mi83ki/servo-pcb/README.md

# servo-pcb

XSA2の本丸駆動用サーボ基板

## 構想設計図

構想設計図は以下になります。
モバイルバッテリー、基板、XSA2を全て回転台の上部に搭載することで、360度回転を継続できる構造とします。
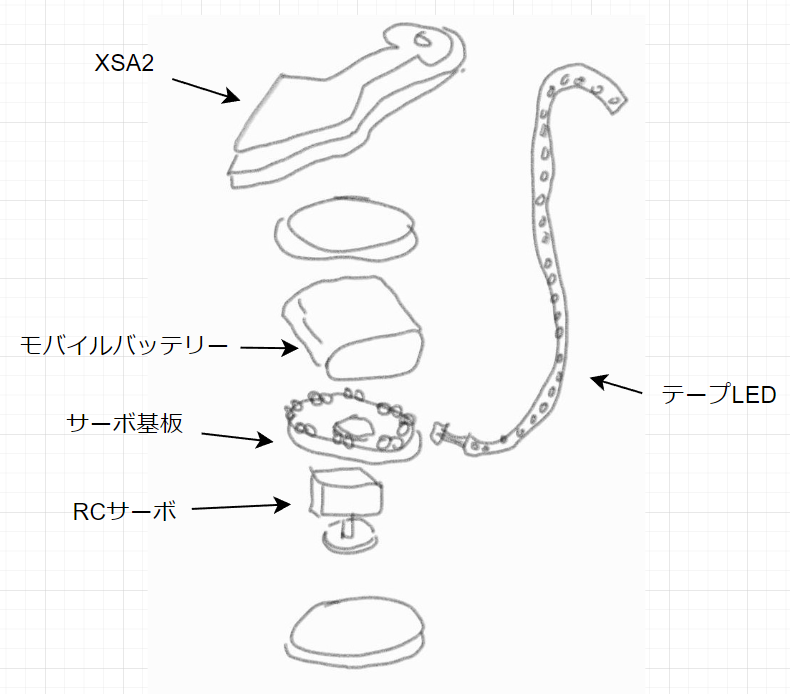
[picture p1: images/conceptualDesign.png]
構想設計図


## 回路ブロック図

回路ブロック図は以下になります。
赤外受発光基板をシールド基板にすることで、拡張可能とします。
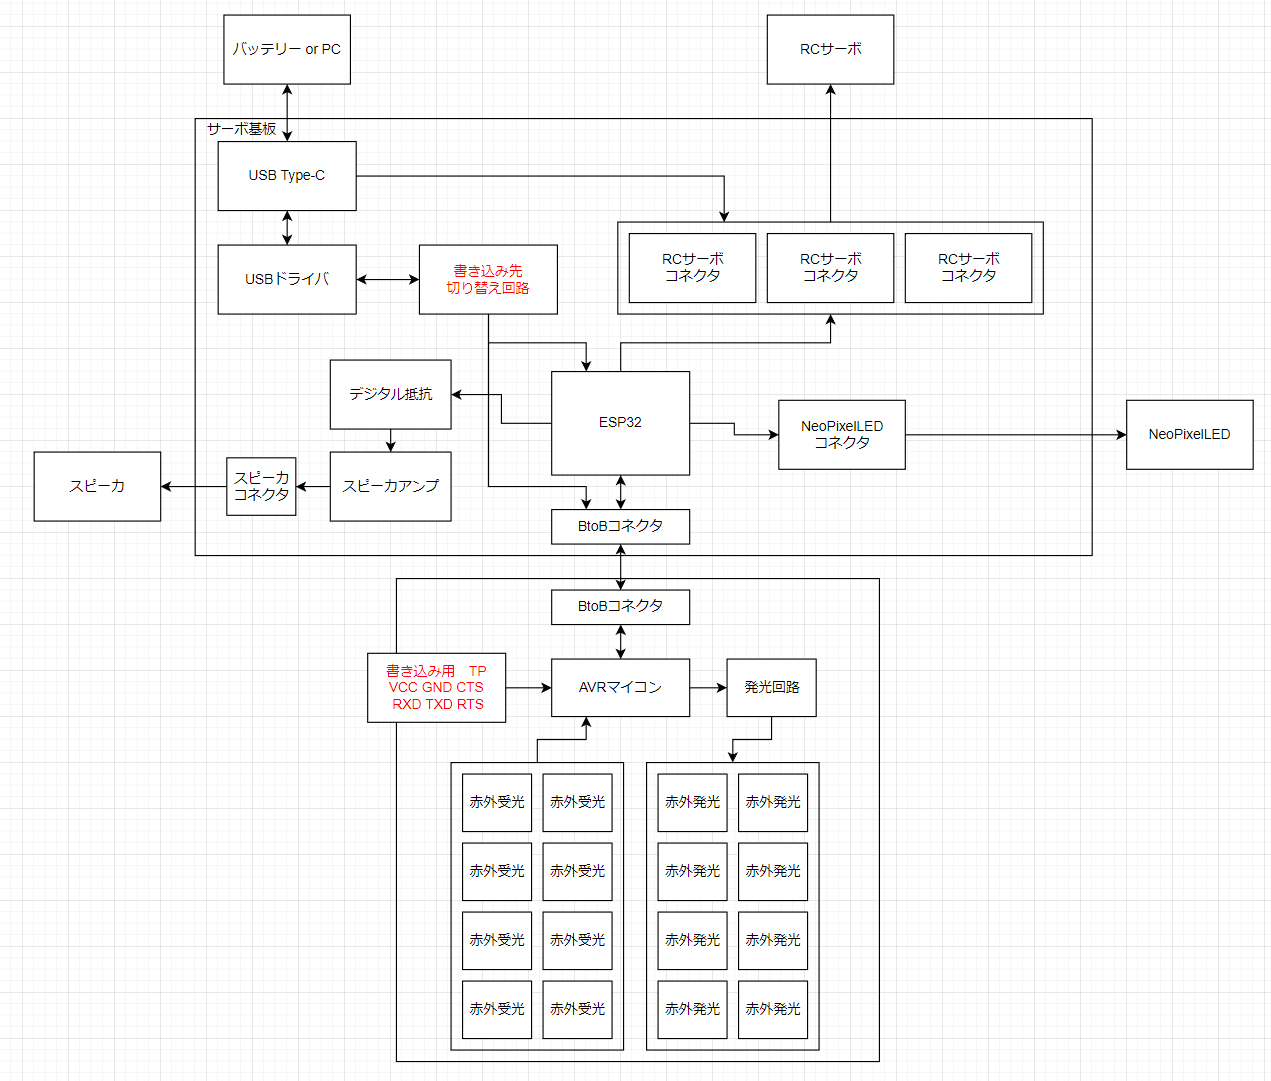
[picture p2: images/circuitDiagram.png]
回路ブロック図
