mi83ki/servo-pcb/dxf/ASSY_ir-pcb_draw.dxf

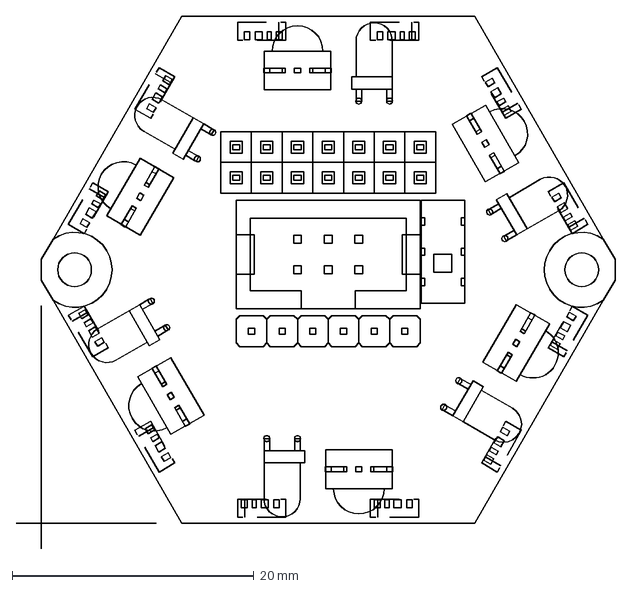
[picture p3: CAD file, 2022-11-27]
dxf/ASSY_ir-pcb_draw.dxf
49.6 x 44.1 mm
