mi83ki/servo-pcb/dxf/ASSY_servo-pcb_draw.dxf

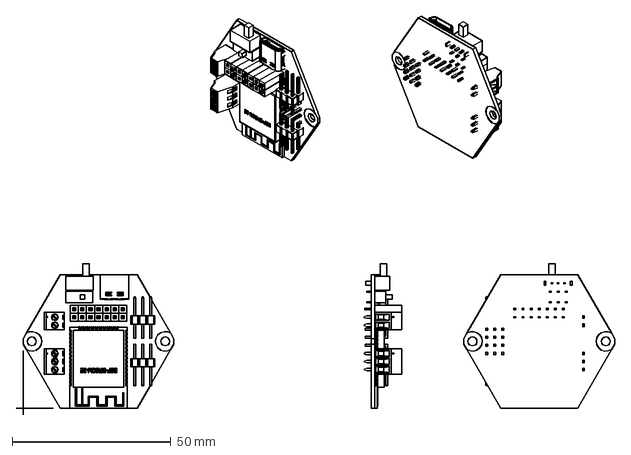
[picture p4: CAD file, 2022-09-03]
dxf/ASSY_servo-pcb_draw.dxf
188.3 x 125.4 mm
