mi83ki/servo-pcb/dxf/pcb_sheet_draw.dxf

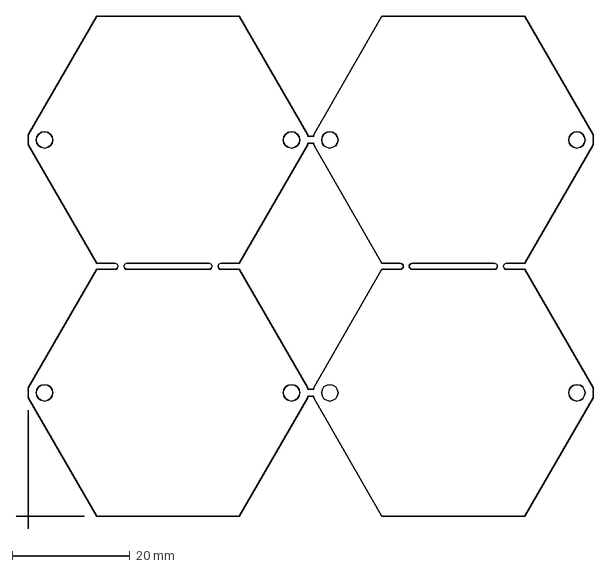
[picture p5: CAD file, 2022-09-03]
dxf/pcb_sheet_draw.dxf
98.1 x 87.1 mm
