mi83ki/servo-pcb/ltspice/IR_led_PMOS.asc

R1: res; 1k
R2: res; 2.5
R3: res; 1k
U1: 2SJ168
V1: voltage; 5
V2: voltage; PULSE(0 3.3 0 0 0 0.01m 0.0263m); AC 1
Named nets: 0
;tran 0.1m
.ac oct 5m 10 100k
