mi83ki/servo-pcb/eagle/xsa2-servo-pcb/servo-pcb.brd

## EAGLE design eagle/xsa2-servo-pcb/servo-pcb.brd (2022-11-27)

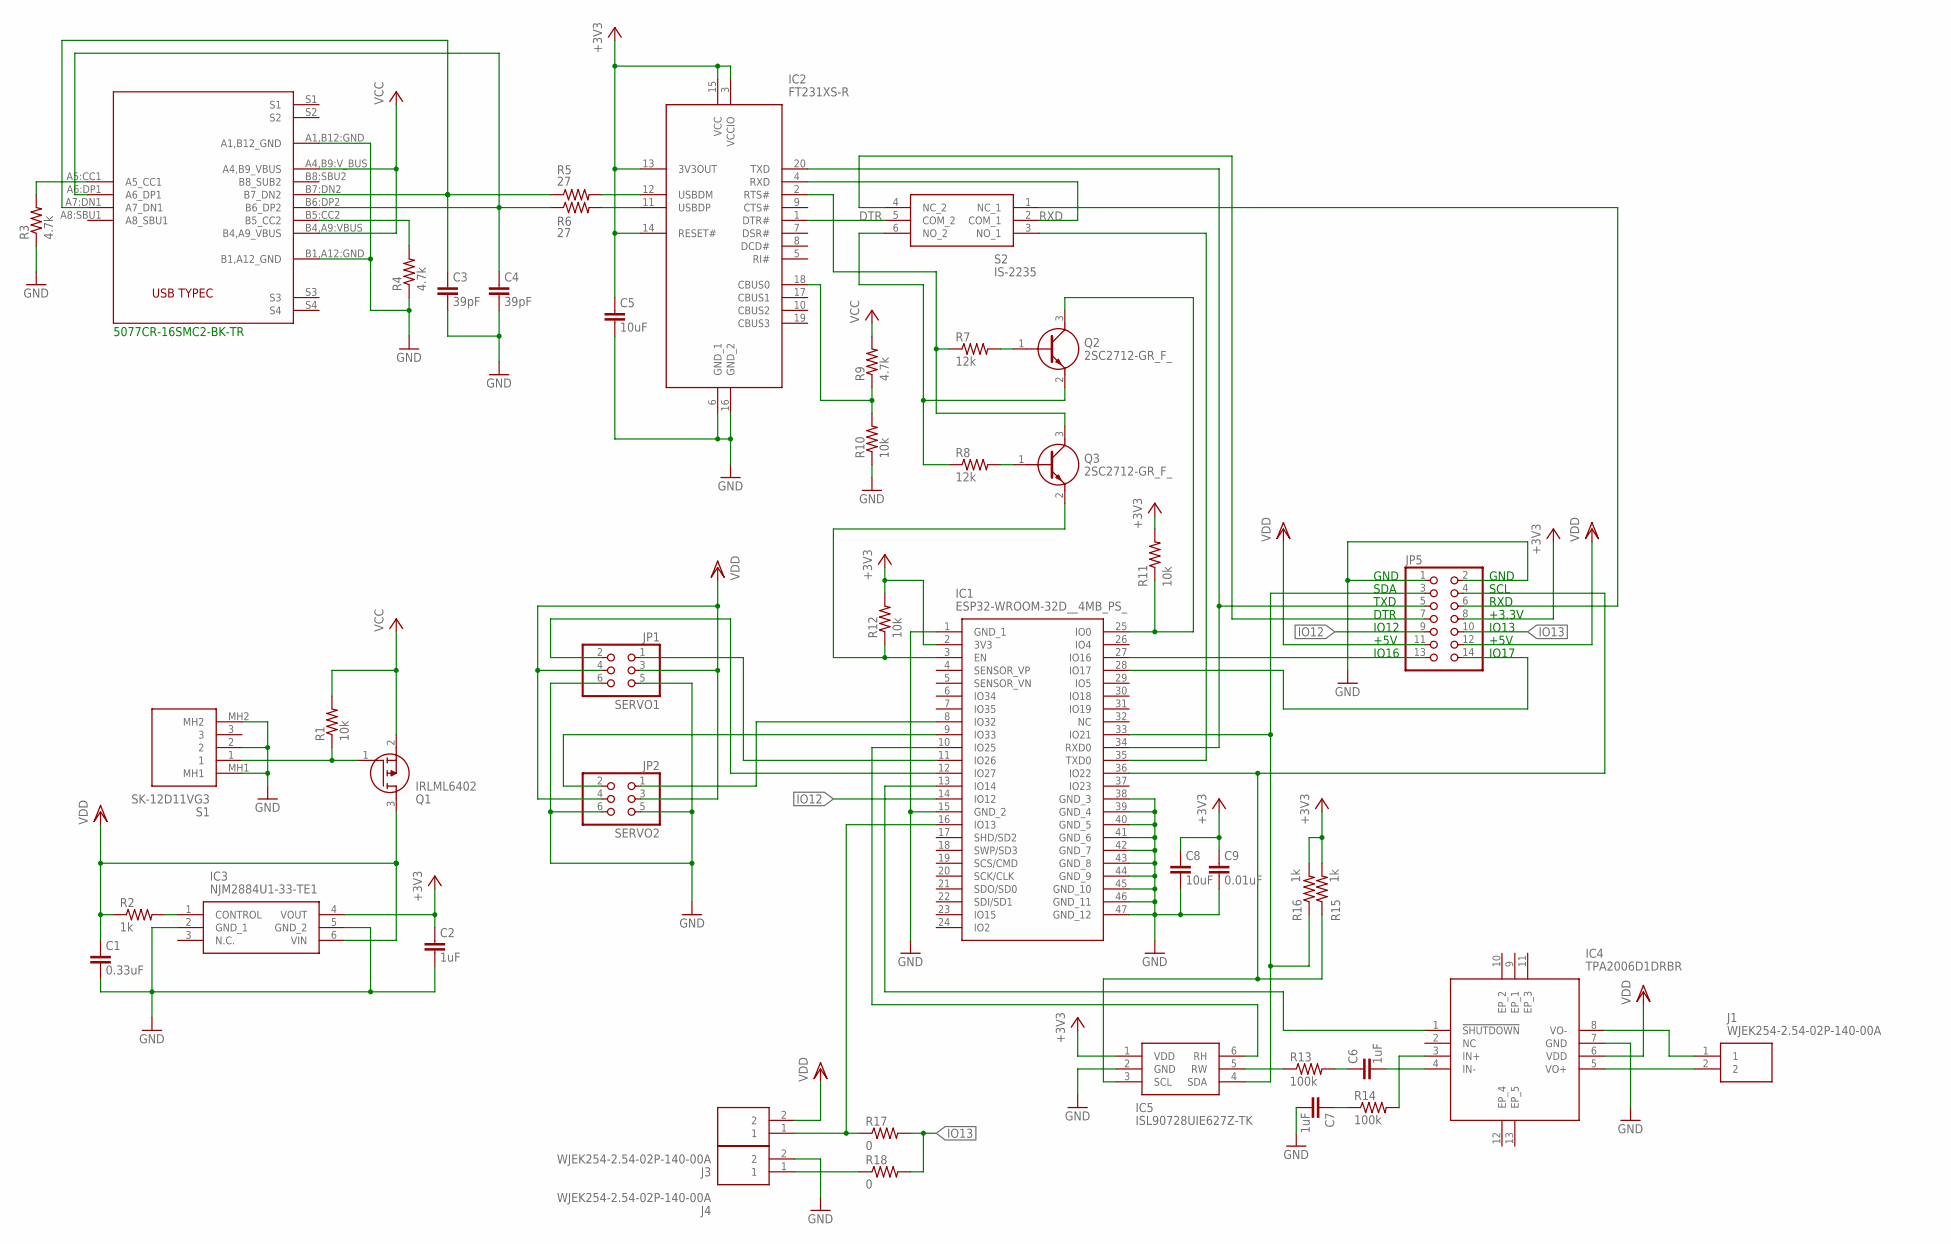
[picture p6: schematic servo-pcb.sch]

Parts:
C1: 0.33uF; C0603
C2, C6, C7: 1uF; C0603
C3, C4: 39pF; C0603
C5, C8: 10uF; C0805
C9: 0.01uF; C0603
IC1: ESP32-WROOM-32D__4MB_PS_; ESP32WROOM32D4MBPS
IC2: FT231XS-R; SOP64P599X175-20N
IC3: NJM2884U1-33-TE1; SOT-89-5-1
IC4: TPA2006D1DRBR
IC5: ISL90728UIE627Z-TK; SOT65P210X110-6N
J1, J3, J4: WJEK254-2.54-02P-140-00A; WJEK25425402P14000A
JP1: SERVO1; 2X03/90
JP2: SERVO2; 2X03/90
JP5: PINHD-2X7; 2X07
Q1: IRLML6402; SOT95P237X112-3N
Q2, Q3: 2SC2712-GR_F_; SSM3K7002CFULF
R1, R10, R11, R12: 10k; R0603
R2, R15, R16: 1k; R0603
R3, R4, R9: 4.7k; R0603
R5, R6: 27; R0603
R7, R8: 12k; R0603
R13, R14: 100k; R0603
R17, R18: 0; R0603
S1: SK-12D11VG3; SK12D11VG3
S2: IS-2235; IS2235
U$1: 5077CR-16-SMC2-BK-TR; 5077CR-16SMC2-BK-TR

Connections:
+3V3: C2.1, C5.1, C8.1, C9.1, IC1.2 (3V3), IC2.3 (VCCIO), IC2.13 (3V3OUT), IC2.14 (RESET#), IC2.15 (VCC), IC3.4 (VOUT), IC5.1 (VDD), JP5.8, R11.2, R12.2, R15.2, R16.2
DTR: IC2.1 (DTR#), S2.5 (COM_2)
GND: C1.2, C2.2, C3.2, C4.2, C5.2, C7.2, C8.2, C9.2, IC1.1 (GND_1), IC1.15 (GND_2), IC1.38 (GND_3), IC1.39 (GND_4), IC1.40 (GND_5), IC1.41 (GND_6), IC1.42 (GND_7), IC1.43 (GND_8), IC1.44 (GND_9), IC1.45 (GND_10), IC1.46 (GND_11), IC1.47 (GND_12), IC2.6 (GND_1), IC2.16 (GND_2), IC3.2 (GND_1), IC3.5 (GND_2), IC4.7 (GND), IC5.2 (GND), J4.2, JP1.5, JP1.6, JP2.5, JP2.6, JP5.1, JP5.2, R3.1, R4.1, R10.1, S1.2, S1.MH1, S1.MH2, U$1.A1,B12:GND (A1,B12_GND), U$1.B1,A12:GND (B1,A12_GND)
IO12: IC1.14 (IO12), JP5.9
IO13: JP5.10, R17.2, R18.2
unnamed: C4.1, R6.1, U$1.A6:DP1 (A6_DP1), U$1.B6:DP2 (B6_DP2)
unnamed: Q1.1 (G), R1.1, S1.1
unnamed: IC3.1 (CONTROL), R2.2
unnamed: IC1.28 (IO17), JP5.14
unnamed: C3.1, R5.1, U$1.A7:DN1 (A7_DN1), U$1.B7:DN2 (B7_DN2)
unnamed: IC1.34 (RXD0), IC2.20 (TXD), JP5.5
unnamed: IC2.12 (USBDM), R5.2
unnamed: IC2.11 (USBDP), R6.2
unnamed: IC2.2 (RTS#), Q3.3 (C), R7.1
unnamed: Q2.1 (B), R7.2
unnamed: Q2.2 (E), R8.1, S2.6 (NO_2)
unnamed: Q3.1 (B), R8.2
unnamed: IC2.18 (CBUS0), R9.1, R10.2
unnamed: IC1.3 (EN), Q3.2 (E), R12.1
unnamed: IC1.25 (IO0), Q2.3 (C), R11.1
unnamed: IC1.35 (TXD0), S2.3 (NO_1)
unnamed: JP5.7, S2.4 (NC_2)
unnamed: IC5.5 (RW), R13.1
unnamed: C6.1, R13.2
unnamed: C6.2, IC4.4 (IN-)
unnamed: IC4.3 (IN+), R14.2
unnamed: C7.1, R14.1
unnamed: IC1.36 (IO22), IC5.3 (SCL), JP5.4, R15.1
unnamed: IC1.33 (IO21), IC5.4 (SDA), JP5.3, R16.1
unnamed: IC1.13 (IO14), IC4.1 (!SHUTDOWN)
unnamed: IC4.8 (VO-), J1.1
unnamed: IC4.5 (VO+), J1.2
unnamed: IC1.10 (IO25), IC5.6 (RH)
unnamed: IC1.16 (IO13), J3.1, R17.1
unnamed: IC1.11 (IO26), JP1.1
unnamed: IC1.12 (IO27), JP1.2
unnamed: IC1.8 (IO32), JP2.1
unnamed: IC1.9 (IO33), JP2.2
unnamed: IC1.27 (IO16), JP5.13
unnamed: R4.2, U$1.B5:CC2 (B5_CC2)
unnamed: J4.1, R18.1
unnamed: JP5.6, S2.1 (NC_1)
unnamed: R3.2, U$1.A5:CC1 (A5_CC1)
RXD: IC2.4 (RXD), S2.2 (COM_1)
VCC: Q1.2 (S), R1.2, R9.2, U$1.A4,B9:V_BUS (A4,B9_VBUS), U$1.B4,A9:VBUS (B4,A9_VBUS)
VDD: C1.1, IC3.6 (VIN), IC4.6 (VDD), J3.2, JP1.3, JP1.4, JP2.3, JP2.4, JP5.11, JP5.12, Q1.3 (D), R2.1

Notes on the sheet:
RXD
TXD
DTR
SDA
SCL
IO16
IO17
IO13
IO12
+5V
GND
5077CR-16SMC2-BK-TR
+3.3V

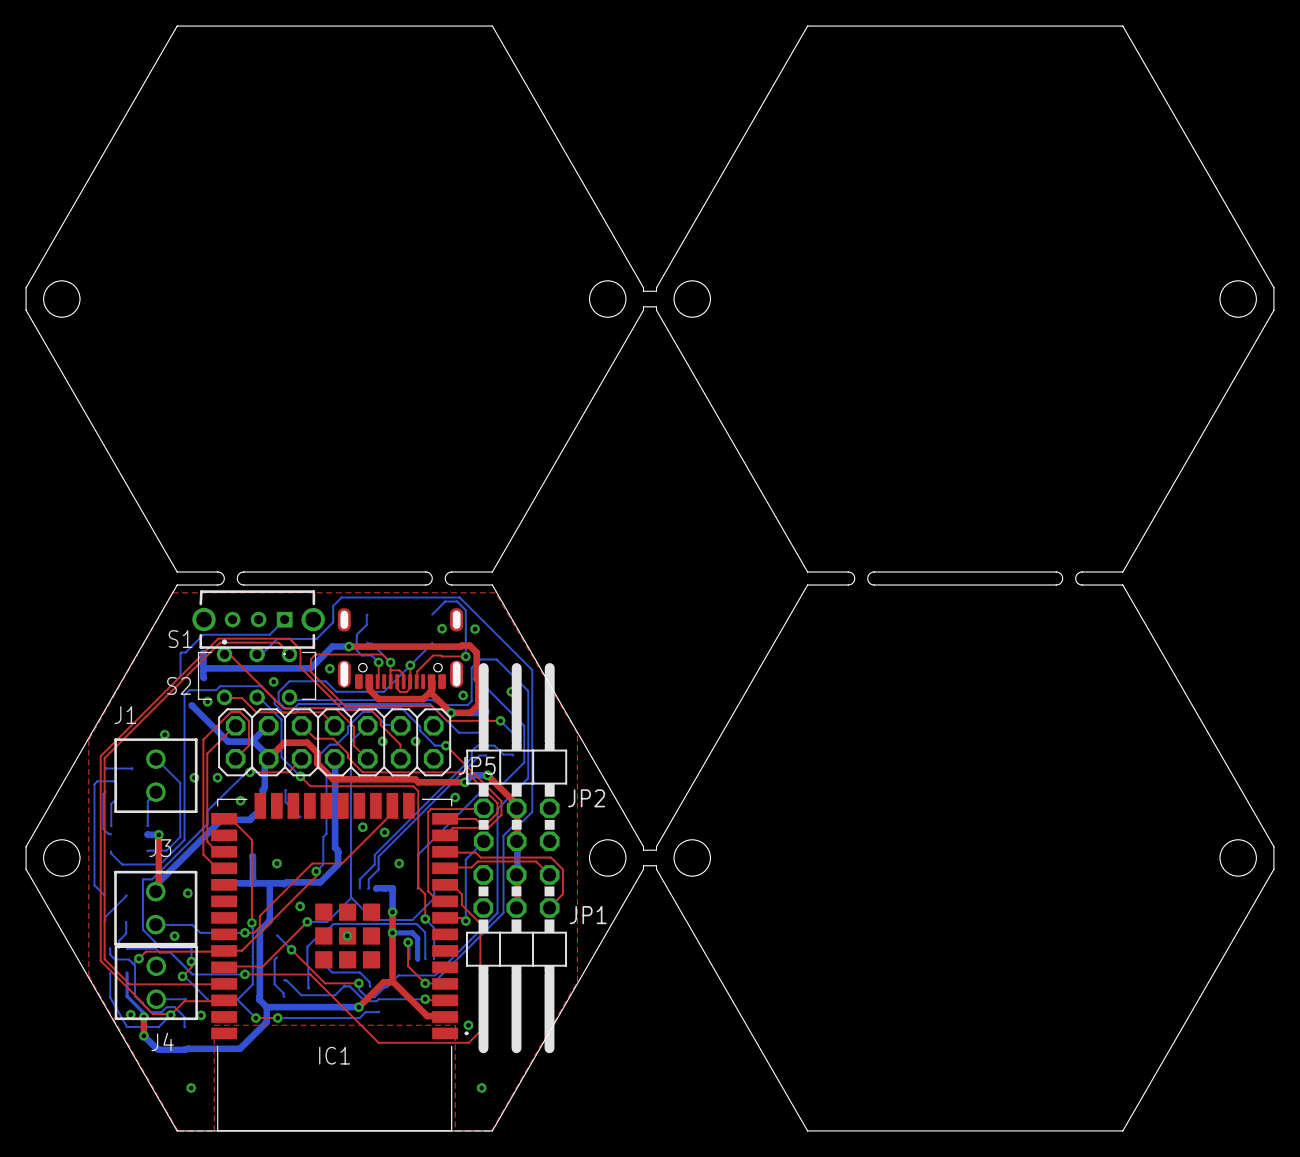
[picture p7: board servo-pcb.brd from above]

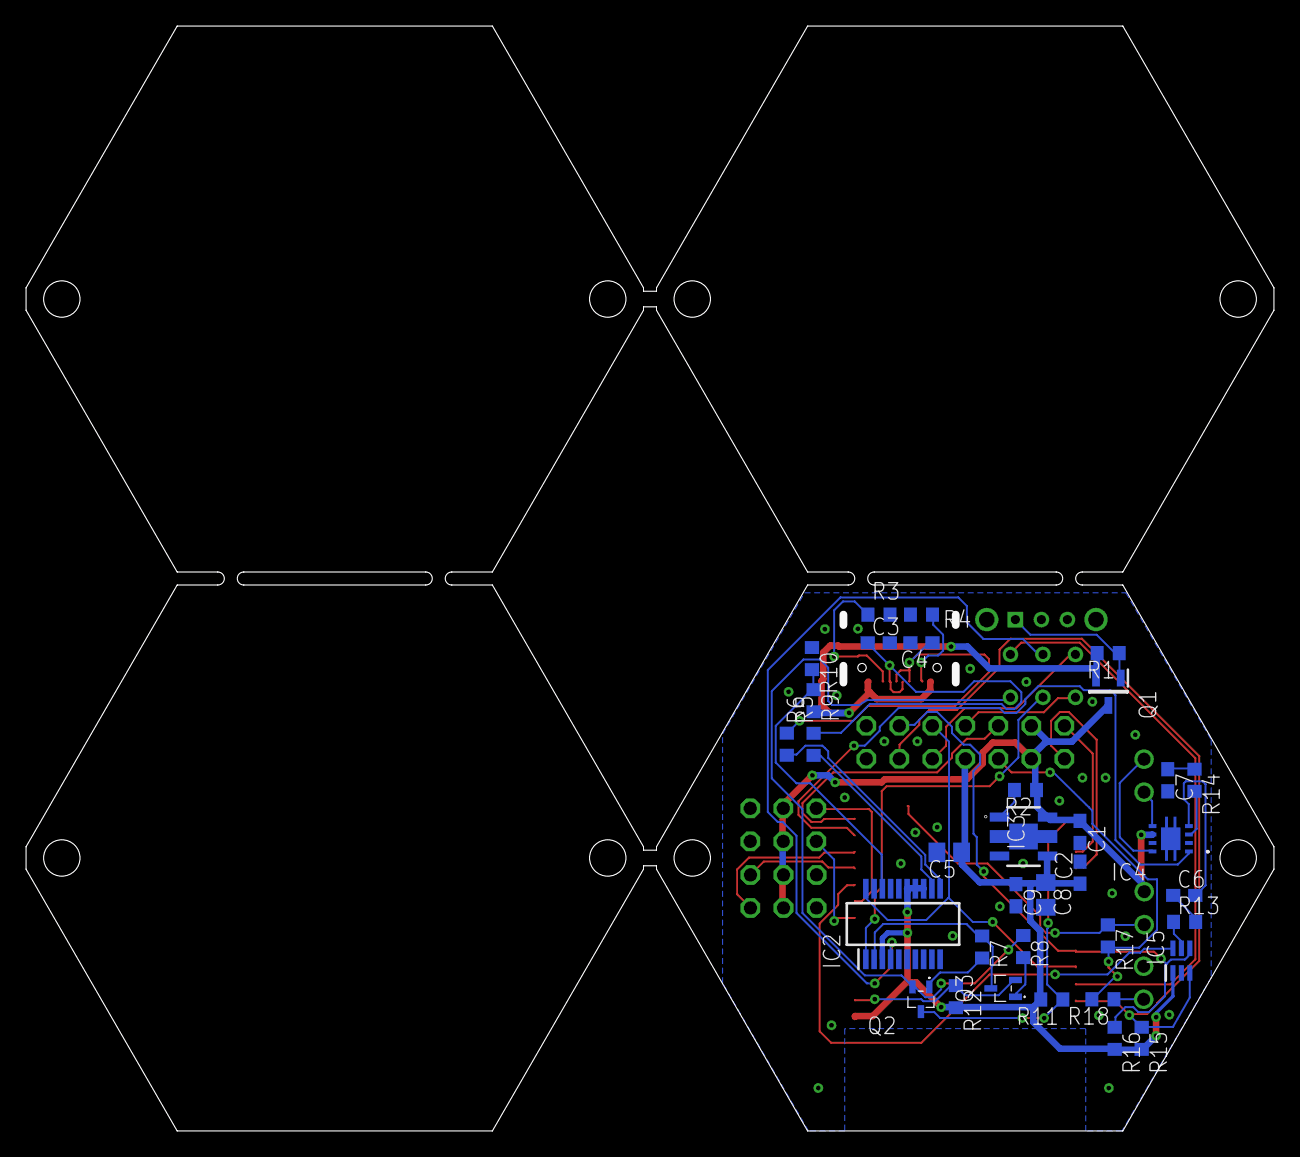
[picture p8: board servo-pcb.brd from below]

Board: 2 copper layers, 96.0 x 85.0 mm, 44 parts (34 on the bottom side), 46 nets.
