mi83ki/servo-pcb/eagle/xsa2-servo-pcb/ir-pcb-sheet.brd

## EAGLE design eagle/xsa2-servo-pcb/ir-pcb-sheet.brd (2023-01-09)

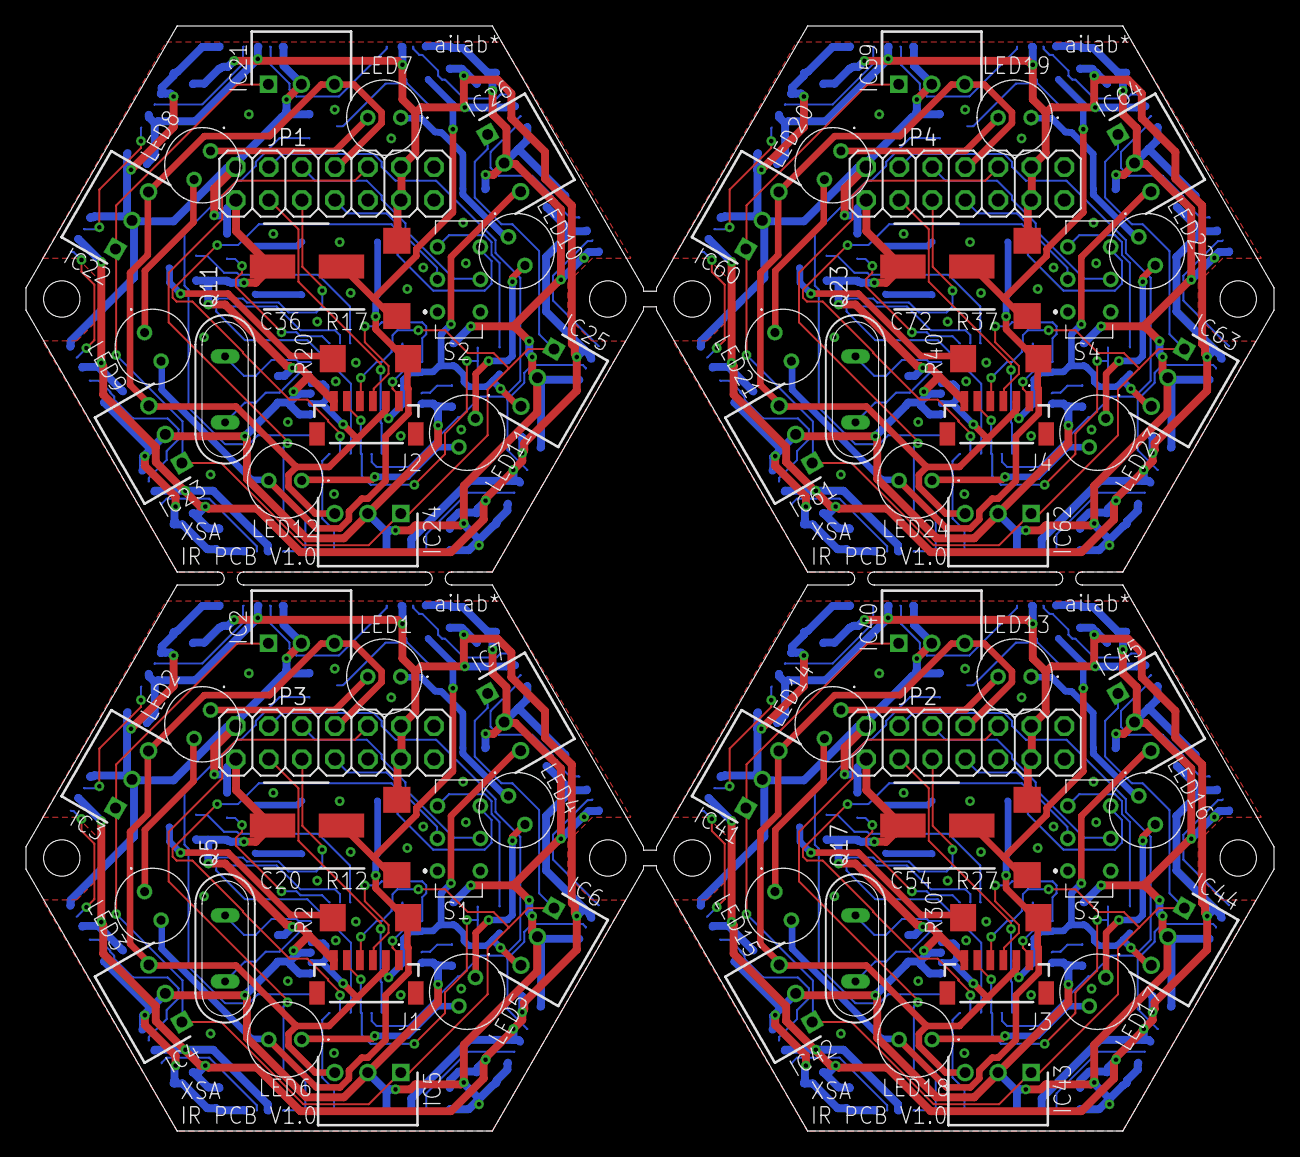
[picture p9: board ir-pcb-sheet.brd from above]

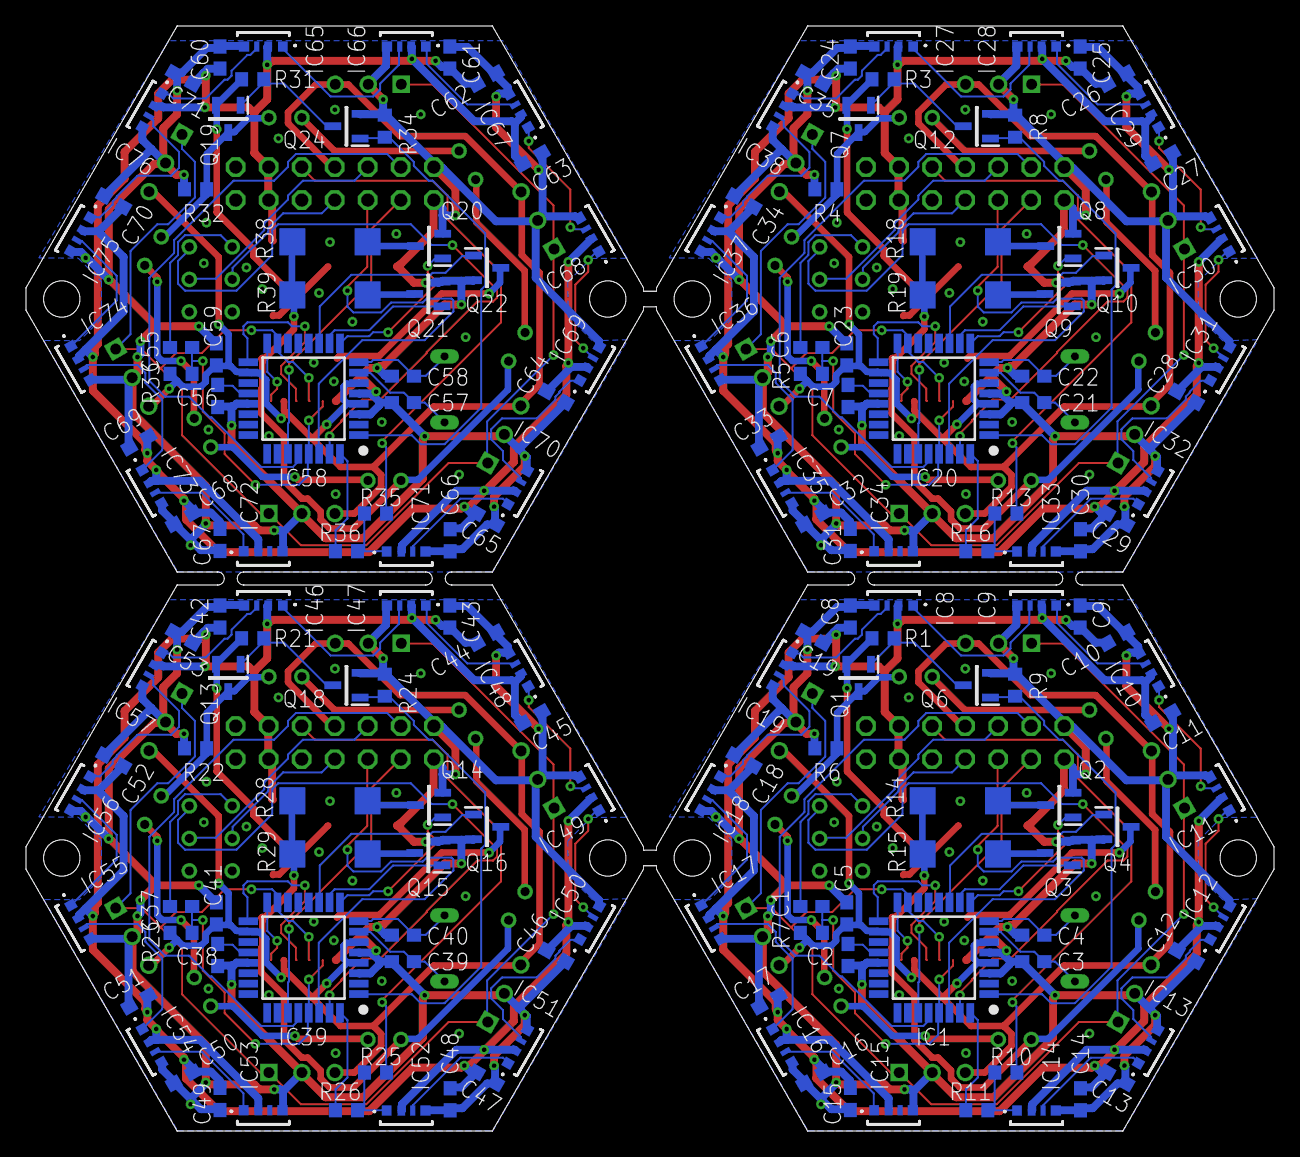
[picture p10: board ir-pcb-sheet.brd from below]

Board: 2 copper layers, 96.0 x 85.0 mm, 248 parts (172 on the bottom side), 184 nets.

Parts:
C1, C2, C5, C6, C7, C8, C9, C10, C11, C12, C13, C14, C15, C16, C17, C18, C19, C23, C24, C25, C26, C27, C28, C29, C30, C31, C32, C33, C34, C35, C37, C38, C41, C42, C43, C44, C45, C46, C47, C48, C49, C50, C51, C52, C53, C55, C56, C59, C60, C61, C62, C63, C64, C65, C66, C67, C68, C69, C70, C71: 0.1u; C0603
C3, C4, C21, C22, C39, C40, C57, C58: 22p; C0603
C20, C36, C54, C72: 25PFV100M6.3X8; CAPAE660X800N
IC1, IC20, IC39, IC58: ATMEGA328P-AU; QFP80P900X900X120-32N
IC2, IC3, IC4, IC5, IC6, IC7, IC21, IC22, IC23, IC24, IC25, IC26, IC40, IC41, IC42, IC43, IC44, IC45, IC59, IC60, IC61, IC62, IC63, IC64: PL-IRM0101; TO254P525X740X825-3P
IC8, IC9, IC10, IC11, IC12, IC13, IC14, IC15, IC16, IC17, IC18, IC19, IC27, IC28, IC29, IC30, IC31, IC32, IC33, IC34, IC35, IC36, IC37, IC38, IC46, IC47, IC48, IC49, IC50, IC51, IC52, IC53, IC54, IC55, IC56, IC57, IC65, IC66, IC67, IC68, IC69, IC70, IC71, IC72, IC73, IC74, IC75, IC76: SK6812_SIDE; SK6812SIDE
J1, J2, J3, J4: BM06B-SRSS-TBT_LF__SN_; BM06BSRSSTBTLFSN
JP1, JP2, JP3, JP4: Stacking Connector; 2X07
LED1, LED2, LED3, LED4, LED5, LED6, LED7, LED8, LED9, LED10, LED11, LED12, LED13, LED14, LED15, LED16, LED17, LED18, LED19, LED20, LED21, LED22, LED23, LED24: OSI5FU5111C-40; OSI5FU5111C40
Q1, Q7, Q13, Q19: IRLML6402; SOT95P237X112-3N
Q2, Q3, Q4, Q6, Q8, Q9, Q10, Q12, Q14, Q15, Q16, Q18, Q20, Q21, Q22, Q24: IRFML8244; SOT95P237X112-3N
Q5, Q11, Q17, Q23: 8MHz; QS
R1, R3, R4, R6, R8, R9, R21, R22, R24, R31, R32, R34: 1k; R0603
R2, R20, R30, R40: 39; R2512W
R5, R7, R23, R33: 10k; R0603
R10, R11, R13, R16, R25, R26, R35, R36: 0; R0603
R12, R17, R27, R37: 1; R2512W
R14, R18, R28, R38: 2; R2512W
R15, R19, R29, R39: 10; R2512W
S1, S2, S3, S4: IS-2235; IS2235

Connections:
+3V1: C23.2, IC20.4, IC20.6, IC20.18, IC21.3, IC22.3, IC23.3, IC24.3, IC25.3, IC26.3, J2.2, JP1.8, R5.1
+3V2: C41.2, IC39.4, IC39.6, IC39.18, IC40.3, IC41.3, IC42.3, IC43.3, IC44.3, IC45.3, J3.2, JP2.8, R23.1
+3V3: C5.2, IC1.4, IC1.6, IC1.18, IC2.3, IC3.3, IC4.3, IC5.3, IC6.3, IC7.3, J1.2, JP3.8, R7.1
+3V4: C59.2, IC58.4, IC58.6, IC58.18, IC59.3, IC60.3, IC61.3, IC62.3, IC63.3, IC64.3, J4.2, JP4.8, R33.1
GND: C2.1, C3.1, C4.1, C5.1, C8.1, C9.1, C10.1, C11.1, C12.1, C13.1, C14.1, C15.1, C16.1, C17.1, C18.1, C19.1, C20.2, IC1.3, IC1.5, IC1.21, IC2.2, IC3.2, IC4.2, IC5.2, IC6.2, IC7.2, IC8.4, IC9.4, IC10.4, IC11.4, IC12.4, IC13.4, IC14.4, IC15.4, IC16.4, IC17.4, IC18.4, IC19.4, J1.6, JP3.1, JP3.2, Q2.2, Q3.2, Q4.2, Q6.2, R6.1, R9.1
GND1: C7.1, C21.1, C22.1, C23.1, C24.1, C25.1, C26.1, C27.1, C28.1, C29.1, C30.1, C31.1, C32.1, C33.1, C34.1, C35.1, C36.2, IC20.3, IC20.5, IC20.21, IC21.2, IC22.2, IC23.2, IC24.2, IC25.2, IC26.2, IC27.4, IC28.4, IC29.4, IC30.4, IC31.4, IC32.4, IC33.4, IC34.4, IC35.4, IC36.4, IC37.4, IC38.4, J2.6, JP1.1, JP1.2, Q8.2, Q9.2, Q10.2, Q12.2, R4.1, R8.1
GND2: C38.1, C39.1, C40.1, C41.1, C42.1, C43.1, C44.1, C45.1, C46.1, C47.1, C48.1, C49.1, C50.1, C51.1, C52.1, C53.1, C54.2, IC39.3, IC39.5, IC39.21, IC40.2, IC41.2, IC42.2, IC43.2, IC44.2, IC45.2, IC46.4, IC47.4, IC48.4, IC49.4, IC50.4, IC51.4, IC52.4, IC53.4, IC54.4, IC55.4, IC56.4, IC57.4, J3.6, JP2.1, JP2.2, Q14.2, Q15.2, Q16.2, Q18.2, R22.1, R24.1
GND3: C56.1, C57.1, C58.1, C59.1, C60.1, C61.1, C62.1, C63.1, C64.1, C65.1, C66.1, C67.1, C68.1, C69.1, C70.1, C71.1, C72.2, IC58.3, IC58.5, IC58.21, IC59.2, IC60.2, IC61.2, IC62.2, IC63.2, IC64.2, IC65.4, IC66.4, IC67.4, IC68.4, IC69.4, IC70.4, IC71.4, IC72.4, IC73.4, IC74.4, IC75.4, IC76.4, J4.6, JP4.1, JP4.2, Q20.2, Q21.2, Q22.2, Q24.2, R32.1, R34.1
LED1: LED1.1, LED4.1, Q1.3, R6.2
LED2: C20.1, Q1.2, R1.1, R12.1
LED3: LED4.2, LED5.1
LED4: LED1.2, LED2.1
LED5: LED5.2, LED6.1
LED6: LED2.2, LED3.1
LED7: LED3.2, LED6.2, R2.2, R14.2, R15.2
LED8: Q2.3, R14.1
LED9: Q3.3, R15.1
LED10: Q4.3, R2.1
LED11: LED7.2, LED8.1
LED12: LED8.2, LED9.1
LED13: LED10.2, LED11.1
LED14: LED11.2, LED12.1
LED15: LED7.1, LED10.1, Q7.3, R4.2
LED16: LED9.2, LED12.2, R18.2, R19.2, R20.2
LED17: Q8.3, R18.1
LED18: Q9.3, R19.1
LED19: Q10.3, R20.1
LED20: C36.1, Q7.2, R3.1, R17.1
LED21: LED13.2, LED14.1
LED22: LED14.2, LED15.1
LED23: LED16.2, LED17.1
LED24: LED17.2, LED18.1
LED25: LED13.1, LED16.1, Q13.3, R22.2
LED26: LED15.2, LED18.2, R28.2, R29.2, R30.2
LED27: Q14.3, R28.1
LED28: Q15.3, R29.1
LED29: Q16.3, R30.1
LED30: C54.1, Q13.2, R21.1, R27.1
LED31: LED19.2, LED20.1
LED32: LED20.2, LED21.1
LED33: LED22.2, LED23.1
LED34: LED23.2, LED24.1
LED35: LED19.1, LED22.1, Q19.3, R32.2
LED36: LED21.2, LED24.2, R38.2, R39.2, R40.2
LED37: Q20.3, R38.1
LED38: Q21.3, R39.1
LED39: Q22.3, R40.1
LED40: C72.1, Q19.2, R31.1, R37.1
unnamed: IC1.16, J1.1
unnamed: Q1.1, Q6.3, R1.2
unnamed: JP3.6, S1.5
unnamed: IC20.17, J2.3
unnamed: IC1.17, J1.3
unnamed: IC20.16, J2.1
unnamed: IC20.1, Q12.1, R8.2
unnamed: IC20.9, Q8.1
unnamed: IC20.10, Q9.1
unnamed: IC1.1, Q6.1, R9.2
unnamed: IC8.1, IC9.3
unnamed: IC20.11, Q10.1
unnamed: C2.2, IC1.20
unnamed: JP3.7, S1.2
unnamed: IC20.28, JP1.4
unnamed: IC20.30, JP1.5
unnamed: C7.2, IC20.20
unnamed: IC1.9, Q2.1
unnamed: IC1.10, Q3.1
unnamed: IC1.11, Q4.1
unnamed: IC1.28, JP3.4
unnamed: C3.2, IC1.7, Q5.1
unnamed: IC1.30, JP3.5
unnamed: IC13.1, IC14.3
unnamed: C1.2, IC1.29, J1.5, R7.2
unnamed: C4.2, IC1.8, Q5.2
unnamed: C21.2, IC20.7, Q11.1
unnamed: C1.1, S1.3
unnamed: IC1.31, S1.6
unnamed: IC1.27, JP3.3
unnamed: IC12.1, IC13.3
unnamed: IC11.1, IC12.3
unnamed: IC10.1, IC11.3
unnamed: IC9.1, IC10.3
unnamed: C22.2, IC20.8, Q11.2
unnamed: IC8.3, IC19.1
unnamed: IC18.1, IC19.3
unnamed: IC17.1, IC18.3
unnamed: IC16.1, IC17.3
unnamed: IC15.1, IC16.3
unnamed: IC1.15, IC2.1, IC3.1, IC4.1, IC5.1, IC6.1, IC7.1, J1.4
unnamed: JP3.10, R10.2
unnamed: IC1.32, R11.2
unnamed: IC14.1, R10.1, R11.1
unnamed: C6.2, IC20.29, J2.5, R5.2
unnamed: C6.1, S2.3
unnamed: Q7.1, Q12.3, R3.2
unnamed: IC20.27, JP1.3
unnamed: JP1.6, S2.5
unnamed: JP1.7, S2.2
unnamed: IC20.31, S2.6
unnamed: JP1.10, R13.2
unnamed: IC20.32, R16.2
unnamed: IC20.15, IC21.1, IC22.1, IC23.1, IC24.1, IC25.1, IC26.1, J2.4
unnamed: IC32.1, IC33.3
unnamed: IC31.1, IC32.3
unnamed: IC30.1, IC31.3
unnamed: IC29.1, IC30.3
unnamed: IC28.1, IC29.3
unnamed: IC33.1, R13.1, R16.1
unnamed: IC27.3, IC38.1
unnamed: IC37.1, IC38.3
unnamed: IC36.1, IC37.3
unnamed: IC35.1, IC36.3
unnamed: IC34.1, IC35.3
unnamed: IC27.1, IC28.3
unnamed: IC39.17, J3.3
unnamed: IC39.16, J3.1
unnamed: IC39.1, Q18.1, R24.2
unnamed: IC39.9, Q14.1
unnamed: IC39.10, Q15.1
unnamed: IC39.11, Q16.1
unnamed: IC39.28, JP2.4
unnamed: IC39.30, JP2.5
unnamed: C38.2, IC39.20
unnamed: C39.2, IC39.7, Q17.1
unnamed: C40.2, IC39.8, Q17.2
unnamed: C37.2, IC39.29, J3.5, R23.2
unnamed: C37.1, S3.3
unnamed: Q13.1, Q18.3, R21.2
unnamed: IC39.27, JP2.3
unnamed: JP2.6, S3.5
unnamed: JP2.7, S3.2
unnamed: IC39.31, S3.6
unnamed: JP2.10, R25.2
unnamed: IC39.32, R26.2
unnamed: IC39.15, IC40.1, IC41.1, IC42.1, IC43.1, IC44.1, IC45.1, J3.4
unnamed: IC51.1, IC52.3
unnamed: IC50.1, IC51.3
unnamed: IC49.1, IC50.3
unnamed: IC48.1, IC49.3
unnamed: IC47.1, IC48.3
unnamed: IC52.1, R25.1, R26.1
unnamed: IC46.3, IC57.1
unnamed: IC56.1, IC57.3
unnamed: IC55.1, IC56.3
unnamed: IC54.1, IC55.3
unnamed: IC53.1, IC54.3
unnamed: IC46.1, IC47.3
unnamed: IC58.17, J4.3
unnamed: IC58.16, J4.1
unnamed: IC58.1, Q24.1, R34.2
unnamed: IC58.9, Q20.1
unnamed: IC58.10, Q21.1
unnamed: IC58.11, Q22.1
unnamed: IC58.28, JP4.4
unnamed: IC58.30, JP4.5
unnamed: C56.2, IC58.20
unnamed: C57.2, IC58.7, Q23.1
unnamed: C58.2, IC58.8, Q23.2
unnamed: C55.2, IC58.29, J4.5, R33.2
unnamed: C55.1, S4.3
unnamed: Q19.1, Q24.3, R31.2
unnamed: IC58.27, JP4.3
unnamed: JP4.6, S4.5
unnamed: JP4.7, S4.2
unnamed: IC58.31, S4.6
unnamed: JP4.10, R35.2
unnamed: IC58.32, R36.2
unnamed: IC58.15, IC59.1, IC60.1, IC61.1, IC62.1, IC63.1, IC64.1, J4.4
unnamed: IC70.1, IC71.3
unnamed: IC69.1, IC70.3
unnamed: IC68.1, IC69.3
unnamed: IC67.1, IC68.3
unnamed: IC66.1, IC67.3
unnamed: IC71.1, R35.1, R36.1
unnamed: IC65.3, IC76.1
unnamed: IC75.1, IC76.3
unnamed: IC74.1, IC75.3
unnamed: IC73.1, IC74.3
unnamed: IC72.1, IC73.3
unnamed: IC65.1, IC66.3
VDD: C8.2, C9.2, C10.2, C11.2, C12.2, C13.2, C14.2, C15.2, C16.2, C17.2, C18.2, C19.2, IC8.2, IC9.2, IC10.2, IC11.2, IC12.2, IC13.2, IC14.2, IC15.2, IC16.2, IC17.2, IC18.2, IC19.2, JP3.11, JP3.12, R12.2
VDD1: C24.2, C25.2, C26.2, C27.2, C28.2, C29.2, C30.2, C31.2, C32.2, C33.2, C34.2, C35.2, IC27.2, IC28.2, IC29.2, IC30.2, IC31.2, IC32.2, IC33.2, IC34.2, IC35.2, IC36.2, IC37.2, IC38.2, JP1.11, JP1.12, R17.2
VDD2: C42.2, C43.2, C44.2, C45.2, C46.2, C47.2, C48.2, C49.2, C50.2, C51.2, C52.2, C53.2, IC46.2, IC47.2, IC48.2, IC49.2, IC50.2, IC51.2, IC52.2, IC53.2, IC54.2, IC55.2, IC56.2, IC57.2, JP2.11, JP2.12, R27.2
VDD3: C60.2, C61.2, C62.2, C63.2, C64.2, C65.2, C66.2, C67.2, C68.2, C69.2, C70.2, C71.2, IC65.2, IC66.2, IC67.2, IC68.2, IC69.2, IC70.2, IC71.2, IC72.2, IC73.2, IC74.2, IC75.2, IC76.2, JP4.11, JP4.12, R37.2
