mi83ki/servo-pcb/eagle/xsa2-servo-pcb/servo-pcb-sheet.brd

## EAGLE design eagle/xsa2-servo-pcb/servo-pcb-sheet.brd (2022-12-30)

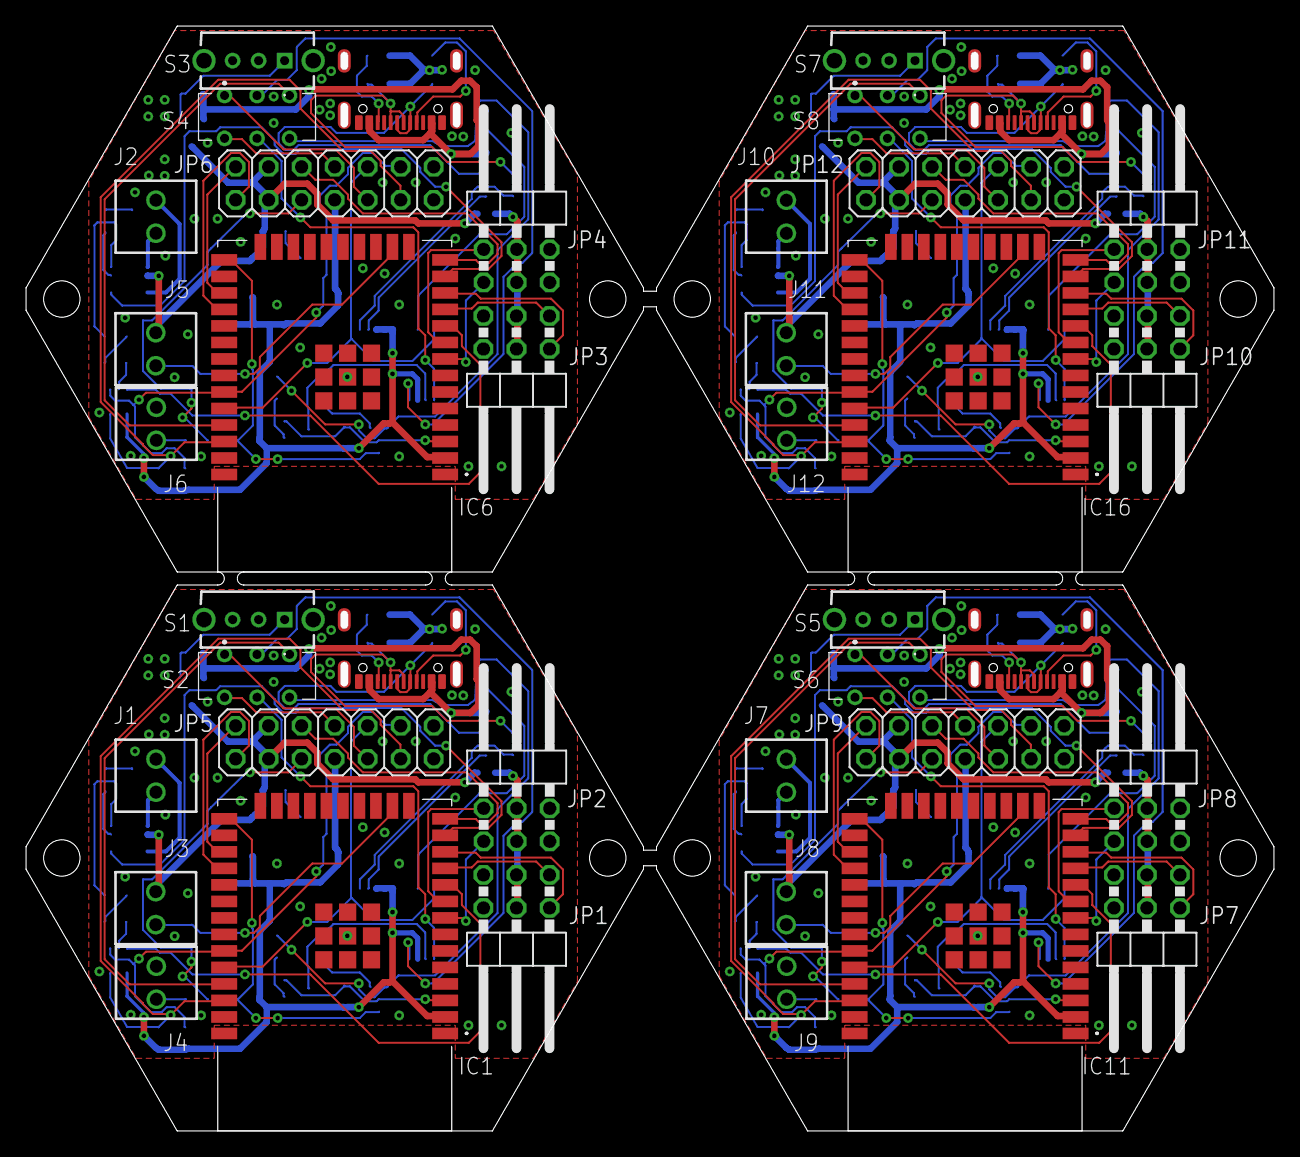
[picture p11: board servo-pcb-sheet.brd from above]

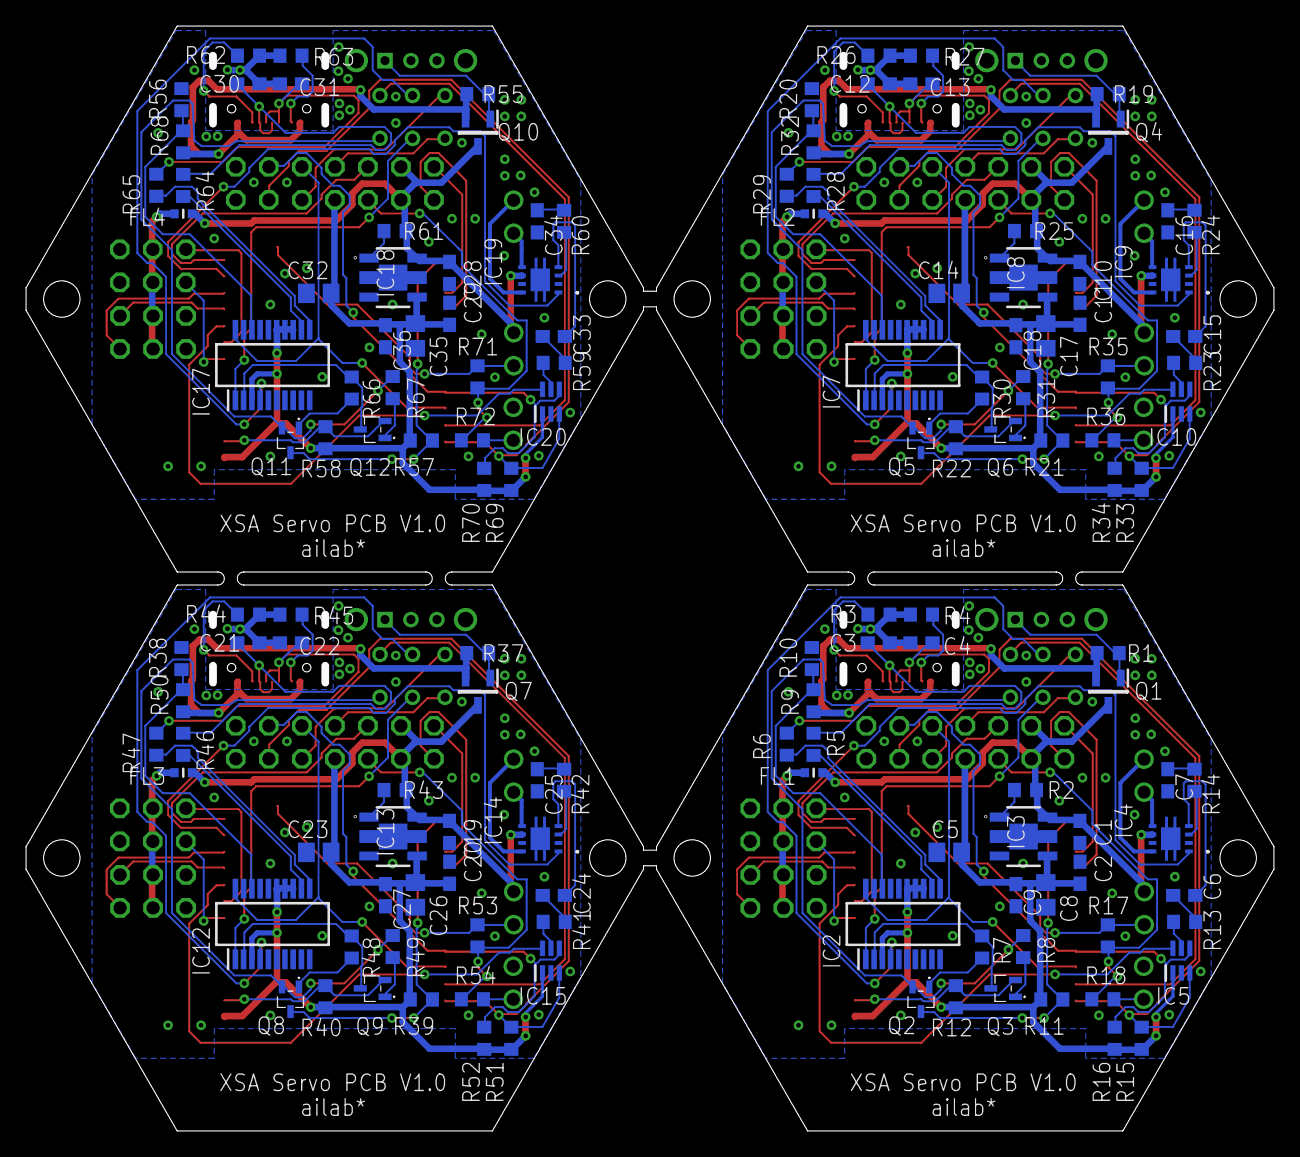
[picture p12: board servo-pcb-sheet.brd from below]

Board: 2 copper layers, 96.0 x 85.0 mm, 180 parts (140 on the bottom side), 188 nets.

Parts:
C1, C10, C19, C28: 0.33uF; C0603
C2, C6, C7, C11, C15, C16, C20, C24, C25, C29, C33, C34: 1uF; C0603
C3, C4, C12, C13, C21, C22, C30, C31: 39pF; C0603
C5, C8, C14, C17, C23, C26, C32, C35: 10uF; C0805
C9, C18, C27, C36: 0.01uF; C0603
FL1, FL2, FL3, FL4: BLM18PG121SN1D; BLM18AG102BH1D
IC1, IC6, IC11, IC16: ESP32-WROOM-32D__4MB_PS_; ESP32WROOM32D4MBPS
IC2, IC7, IC12, IC17: FT231XS-R; SOP64P599X175-20N
IC3, IC8, IC13, IC18: NJM2884U1-33-TE1; SOT-89-5-1
IC4, IC9, IC14, IC19: TPA2006D1DRBR
IC5, IC10, IC15, IC20: ISL90728UIE627Z-TK; SOT65P210X110-6N
J1, J2, J3, J4, J5, J6, J7, J8, J9, J10, J11, J12: WJEK254-2.54-02P-140-00A; WJEK25425402P14000A
JP1, JP3, JP7, JP10: SERVO1; 2X03/90
JP2, JP4, JP8, JP11: SERVO2; 2X03/90
JP5, JP6, JP9, JP12: 2X07
Q1, Q4, Q7, Q10: IRLML6402; SOT95P237X112-3N
Q2, Q3, Q5, Q6, Q8, Q9, Q11, Q12: 2SC2712-GR_F_; SSM3K7002CFULF
R1, R10, R11, R12, R19, R20, R21, R22, R37, R38, R39, R40, R55, R56, R57, R58: 10k; R0603
R2, R15, R16, R25, R33, R34, R43, R51, R52, R61, R69, R70: 1k; R0603
R3, R4, R9, R26, R27, R32, R44, R45, R50, R62, R63, R68: 4.7k; R0603
R5, R6, R28, R29, R46, R47, R64, R65: 27; R0603
R7, R8, R30, R31, R48, R49, R66, R67: 12k; R0603
R13, R14, R23, R24, R41, R42, R59, R60: 100k; R0603
R17, R18, R35, R36, R53, R54, R71, R72: 0; R0603
S1, S3, S5, S7: SK-12D11VG3; SK12D11VG3
S2, S4, S6, S8: IS-2235; IS2235
U$1, U$2, U$3, U$4: 5077CR-16-SMC2-BK-TR; 5077CR-16SMC2-BK-TR

Connections:
+3V1: C11.1, C14.1, C17.1, C18.1, IC6.2, IC7.3, IC7.13, IC7.14, IC7.15, IC8.4, IC10.1, JP6.8, R21.2, R22.2, R33.2, R34.2
+3V2: C20.1, C23.1, C26.1, C27.1, IC11.2, IC12.3, IC12.13, IC12.14, IC12.15, IC13.4, IC15.1, JP9.8, R39.2, R40.2, R51.2, R52.2
+3V3: C2.1, C5.1, C8.1, C9.1, IC1.2, IC2.3, IC2.13, IC2.14, IC2.15, IC3.4, IC5.1, JP5.8, R11.2, R12.2, R15.2, R16.2
+3V4: C29.1, C32.1, C35.1, C36.1, IC16.2, IC17.3, IC17.13, IC17.14, IC17.15, IC18.4, IC20.1, JP12.8, R57.2, R58.2, R69.2, R70.2
DTR: IC2.1, S2.5
DTR1: IC7.1, S4.5
DTR2: IC12.1, S6.5
DTR3: IC17.1, S8.5
GND: C1.2, C2.2, C3.2, C4.2, C5.2, C7.2, C8.2, C9.2, IC1.1, IC1.15, IC1.38, IC1.39, IC1.40, IC1.41, IC1.42, IC1.43, IC1.44, IC1.45, IC1.46, IC1.47, IC2.6, IC2.16, IC3.2, IC3.5, IC4.7, IC5.2, J4.2, JP1.5, JP1.6, JP2.5, JP2.6, JP5.1, JP5.2, R3.1, R4.1, R10.1, S1.2, S1.MH1, S1.MH2, U$1.A1,B12:GND, U$1.B1,A12:GND
GND1: C10.2, C11.2, C12.2, C13.2, C14.2, C16.2, C17.2, C18.2, IC6.1, IC6.15, IC6.38, IC6.39, IC6.40, IC6.41, IC6.42, IC6.43, IC6.44, IC6.45, IC6.46, IC6.47, IC7.6, IC7.16, IC8.2, IC8.5, IC9.7, IC10.2, J6.2, JP3.5, JP3.6, JP4.5, JP4.6, JP6.1, JP6.2, R20.1, R26.1, R27.1, S3.2, S3.MH1, S3.MH2, U$2.A1,B12:GND, U$2.B1,A12:GND
GND2: C19.2, C20.2, C21.2, C22.2, C23.2, C25.2, C26.2, C27.2, IC11.1, IC11.15, IC11.38, IC11.39, IC11.40, IC11.41, IC11.42, IC11.43, IC11.44, IC11.45, IC11.46, IC11.47, IC12.6, IC12.16, IC13.2, IC13.5, IC14.7, IC15.2, J9.2, JP7.5, JP7.6, JP8.5, JP8.6, JP9.1, JP9.2, R38.1, R44.1, R45.1, S5.2, S5.MH1, S5.MH2, U$3.A1,B12:GND, U$3.B1,A12:GND
GND3: C28.2, C29.2, C30.2, C31.2, C32.2, C34.2, C35.2, C36.2, IC16.1, IC16.15, IC16.38, IC16.39, IC16.40, IC16.41, IC16.42, IC16.43, IC16.44, IC16.45, IC16.46, IC16.47, IC17.6, IC17.16, IC18.2, IC18.5, IC19.7, IC20.2, J12.2, JP10.5, JP10.6, JP11.5, JP11.6, JP12.1, JP12.2, R56.1, R62.1, R63.1, S7.2, S7.MH1, S7.MH2, U$4.A1,B12:GND, U$4.B1,A12:GND
IO1: IC6.14, JP6.9
IO2: JP6.10, R35.2, R36.2
IO3: IC11.14, JP9.9
IO4: JP9.10, R53.2, R54.2
IO5: IC16.14, JP12.9
IO6: JP12.10, R71.2, R72.2
IO12: IC1.14, JP5.9
IO13: JP5.10, R17.2, R18.2
unnamed: C4.1, R6.1, U$1.A6:DP1, U$1.B6:DP2
unnamed: Q1.1, R1.1, S1.1
unnamed: IC3.1, R2.2
unnamed: IC1.28, JP5.14
unnamed: C3.1, R5.1, U$1.A7:DN1, U$1.B7:DN2
unnamed: IC1.34, IC2.20, JP5.5
unnamed: IC2.12, R5.2
unnamed: IC2.11, R6.2
unnamed: IC2.2, Q3.3, R7.1
unnamed: Q2.1, R7.2
unnamed: Q2.2, R8.1, S2.6
unnamed: Q3.1, R8.2
unnamed: IC2.18, R9.1, R10.2
unnamed: IC1.3, Q3.2, R12.1
unnamed: IC1.25, Q2.3, R11.1
unnamed: IC1.35, S2.3
unnamed: JP5.7, S2.4
unnamed: IC5.5, R13.1
unnamed: C6.1, R13.2
unnamed: C6.2, IC4.4
unnamed: IC4.3, R14.2
unnamed: C7.1, R14.1
unnamed: IC1.36, IC5.3, JP5.4, R15.1
unnamed: IC1.33, IC5.4, JP5.3, R16.1
unnamed: IC1.13, IC4.1
unnamed: IC4.8, J1.1
unnamed: IC4.5, J1.2
unnamed: IC1.10, IC5.6
unnamed: IC1.16, J3.1, R17.1
unnamed: IC1.11, JP1.1
unnamed: IC1.12, JP1.2
unnamed: IC1.8, JP2.1
unnamed: IC1.9, JP2.2
unnamed: IC1.27, JP5.13
unnamed: R4.2, U$1.B5:CC2
unnamed: J4.1, R18.1
unnamed: Q4.1, R19.1, S3.1
unnamed: FL1.1, JP1.3, JP1.4, JP2.3, JP2.4
unnamed: IC8.1, R25.2
unnamed: C13.1, R29.1, U$2.A6:DP1, U$2.B6:DP2
unnamed: JP5.6, S2.1
unnamed: R3.2, U$1.A5:CC1
unnamed: C12.1, R28.1, U$2.A7:DN1, U$2.B7:DN2
unnamed: IC7.12, R28.2
unnamed: IC7.11, R29.2
unnamed: IC7.2, Q6.3, R30.1
unnamed: Q5.1, R30.2
unnamed: Q5.2, R31.1, S4.6
unnamed: Q6.1, R31.2
unnamed: IC7.18, R20.2, R32.1
unnamed: IC6.3, Q6.2, R22.1
unnamed: IC6.25, Q5.3, R21.1
unnamed: IC6.35, S4.3
unnamed: IC10.5, R23.1
unnamed: C15.1, R23.2
unnamed: C15.2, IC9.4
unnamed: IC9.3, R24.2
unnamed: C16.1, R24.1
unnamed: IC6.36, IC10.3, JP6.4, R33.1
unnamed: IC6.33, IC10.4, JP6.3, R34.1
unnamed: IC6.13, IC9.1
unnamed: IC9.8, J2.1
unnamed: IC9.5, J2.2
unnamed: IC6.10, IC10.6
unnamed: IC6.11, JP3.1
unnamed: IC6.12, JP3.2
unnamed: IC6.8, JP4.1
unnamed: IC6.9, JP4.2
unnamed: IC6.27, JP6.13
unnamed: JP6.7, S4.4
unnamed: JP6.6, S4.1
unnamed: R27.2, U$2.B5:CC2
unnamed: R26.2, U$2.A5:CC1
unnamed: IC6.28, JP6.14
unnamed: IC6.34, IC7.20, JP6.5
unnamed: IC6.16, J5.1, R35.1
unnamed: J6.1, R36.1
unnamed: FL2.1, JP3.3, JP3.4, JP4.3, JP4.4
unnamed: Q7.1, R37.1, S5.1
unnamed: IC13.1, R43.2
unnamed: C22.1, R47.1, U$3.A6:DP1, U$3.B6:DP2
unnamed: C21.1, R46.1, U$3.A7:DN1, U$3.B7:DN2
unnamed: IC12.12, R46.2
unnamed: IC12.11, R47.2
unnamed: IC12.2, Q9.3, R48.1
unnamed: Q8.1, R48.2
unnamed: Q8.2, R49.1, S6.6
unnamed: Q9.1, R49.2
unnamed: IC12.18, R38.2, R50.1
unnamed: IC11.3, Q9.2, R40.1
unnamed: IC11.25, Q8.3, R39.1
unnamed: IC11.35, S6.3
unnamed: IC15.5, R41.1
unnamed: C24.1, R41.2
unnamed: C24.2, IC14.4
unnamed: IC14.3, R42.2
unnamed: C25.1, R42.1
unnamed: IC11.36, IC15.3, JP9.4, R51.1
unnamed: IC11.33, IC15.4, JP9.3, R52.1
unnamed: IC11.13, IC14.1
unnamed: IC14.8, J7.1
unnamed: IC14.5, J7.2
unnamed: IC11.10, IC15.6
unnamed: IC11.11, JP7.1
unnamed: IC11.12, JP7.2
unnamed: IC11.8, JP8.1
unnamed: IC11.9, JP8.2
unnamed: IC11.27, JP9.13
unnamed: JP9.7, S6.4
unnamed: JP9.6, S6.1
unnamed: R45.2, U$3.B5:CC2
unnamed: R44.2, U$3.A5:CC1
unnamed: IC11.28, JP9.14
unnamed: IC11.34, IC12.20, JP9.5
unnamed: IC11.16, J8.1, R53.1
unnamed: J9.1, R54.1
unnamed: FL3.1, JP7.3, JP7.4, JP8.3, JP8.4
unnamed: Q10.1, R55.1, S7.1
unnamed: IC18.1, R61.2
unnamed: C31.1, R65.1, U$4.A6:DP1, U$4.B6:DP2
unnamed: C30.1, R64.1, U$4.A7:DN1, U$4.B7:DN2
unnamed: IC17.12, R64.2
unnamed: IC17.11, R65.2
unnamed: IC17.2, Q12.3, R66.1
unnamed: Q11.1, R66.2
unnamed: Q11.2, R67.1, S8.6
unnamed: Q12.1, R67.2
unnamed: IC17.18, R56.2, R68.1
unnamed: IC16.3, Q12.2, R58.1
unnamed: IC16.25, Q11.3, R57.1
unnamed: IC16.35, S8.3
unnamed: IC20.5, R59.1
unnamed: C33.1, R59.2
unnamed: C33.2, IC19.4
unnamed: IC19.3, R60.2
unnamed: C34.1, R60.1
unnamed: IC16.36, IC20.3, JP12.4, R69.1
unnamed: IC16.33, IC20.4, JP12.3, R70.1
unnamed: IC16.13, IC19.1
unnamed: IC19.8, J10.1
unnamed: IC19.5, J10.2
unnamed: IC16.10, IC20.6
unnamed: IC16.11, JP10.1
unnamed: IC16.12, JP10.2
unnamed: IC16.8, JP11.1
unnamed: IC16.9, JP11.2
unnamed: IC16.27, JP12.13
unnamed: JP12.7, S8.4
unnamed: JP12.6, S8.1
unnamed: R63.2, U$4.B5:CC2
unnamed: R62.2, U$4.A5:CC1
unnamed: IC16.28, JP12.14
unnamed: IC16.34, IC17.20, JP12.5
unnamed: IC16.16, J11.1, R71.1
unnamed: J12.1, R72.1
unnamed: FL4.1, JP10.3, JP10.4, JP11.3, JP11.4
RXD: IC2.4, S2.2
RXD1: IC7.4, S4.2
RXD2: IC12.4, S6.2
RXD3: IC17.4, S8.2
VCC: Q1.2, R1.2, R9.2, U$1.A4,B9:V_BUS, U$1.B4,A9:VBUS
VCC1: Q4.2, R19.2, R32.2, U$2.A4,B9:V_BUS, U$2.B4,A9:VBUS
VCC2: Q7.2, R37.2, R50.2, U$3.A4,B9:V_BUS, U$3.B4,A9:VBUS
VCC3: Q10.2, R55.2, R68.2, U$4.A4,B9:V_BUS, U$4.B4,A9:VBUS
VDD: C1.1, FL1.2, IC3.6, IC4.6, J3.2, JP5.11, JP5.12, Q1.3, R2.1
VDD1: C10.1, FL2.2, IC8.6, IC9.6, J5.2, JP6.11, JP6.12, Q4.3, R25.1
VDD2: C19.1, FL3.2, IC13.6, IC14.6, J8.2, JP9.11, JP9.12, Q7.3, R43.1
VDD3: C28.1, FL4.2, IC18.6, IC19.6, J11.2, JP12.11, JP12.12, Q10.3, R61.1
