mi83ki/servo-pcb/(commit log)

2022-07-23 eagleプロジェクトの追加
    [ir-pcb.brd, ir-pcb.sch, servo-pcb.brd, servo-pcb.sch]
2022-08-06 [README] 資料の更新
2022-08-06 [eagle] 部品追加
    [ir-pcb.brd, ir-pcb.sch]
2022-08-06 [eagle] 基板設計追加
    [ir-pcb.brd, ir-pcb.sch, servo-pcb.sch]
2022-08-07 [eagle] 回路追加
    [ir-pcb.brd, ir-pcb.sch, servo-pcb.brd, servo-pcb.sch]
2022-08-07 [eagle] AVRの赤外受光ピンを変更
    [ir-pcb.brd, ir-pcb.sch, servo-pcb.brd, servo-pcb.sch]
2022-08-07 [eagle] 赤外発光部のPMOSにNMOSを追加
    [ir-pcb.brd, ir-pcb.sch]
2022-08-07 [eagle] 回路図更新
    [servo-pcb.brd, servo-pcb.sch]
2022-08-08 [eagle] 連結コネクタのピン数を増加
    [ir-pcb.brd, ir-pcb.sch, servo-pcb.sch]
2022-09-03 [eagle] パターン追加
    [servo-pcb.brd, servo-pcb.sch]
2022-09-03 [dxf] 基板外形図の追加
    [ASSY_servo-pcb_draw.dxf, pcb_sheet_draw.dxf]
2022-10-22 [eagle] メイン基板パターン設計完了
    [servo-pcb.brd, servo-pcb.sch]
2022-11-20 [dxf] IR基板のDXFデータを追加
    [ASSY_ir-pcb_draw.dxf]
2022-11-20 [eagle] IR基板のパターン設計
    [ir-pcb.brd, ir-pcb.sch]
2022-11-27 [eagle] サーボ基板の更新
    [servo-pcb.brd]
2022-11-27 [eagle] サーボ基板完成
    [ir-pcb.brd, ir-pcb.sch, servo-pcb-sheet.brd, servo-pcb.sch]
2022-12-30 [eagle] サーボ基板の面付け
    [servo-pcb-sheet.brd]
2022-12-30 [gerberdata] 手配用のガーバーデータ作成
2023-01-09 [eagle] IR基板の更新
    [ir-pcb.brd, ir-pcb.sch]
2023-01-09 [eagle] IR基板の面付け
    [ir-pcb-sheet.brd]
2023-01-09 [eagle] IR基板のガーバーデータ
2023-03-19 [gitignore] .gitignoreを追加
2023-03-20 [src] ArduinoCommonライブラリを追加
2023-03-20 [src] サーボ駆動プログラムの新規追加
