mi83ki/servo-pcb/(notices)

Notices in the files:
parts and their libraries:
FaBo-Connetor: Released under the Creative Commons Attribution-ShareAlike 4.0 License
https://creativecommons.org/licenses/by-sa/4.0
